NibblesLab/ScanConv/ScanConv.BMP

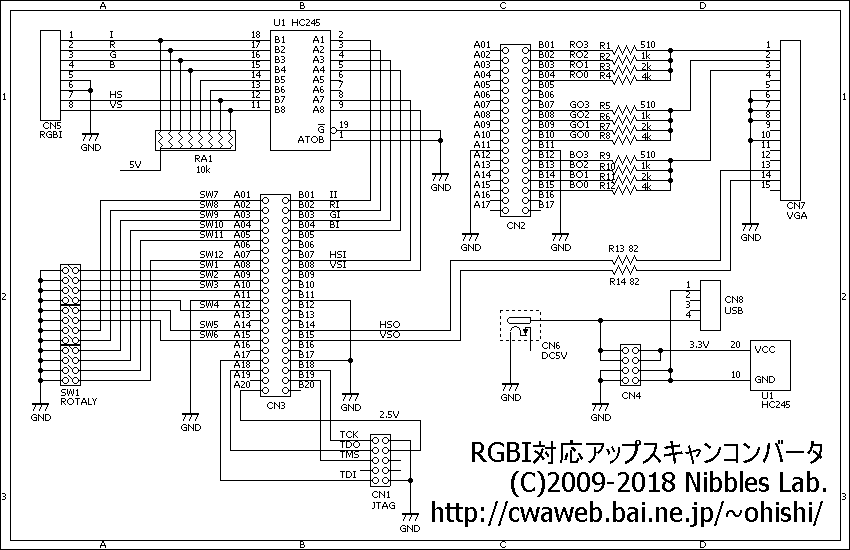
ScanConv.BMP
