NibblesLab/ScanConv/ScanConv.vhd

--
-- Scan Converter for RGBI by Spartan-3E
--
--   (c)2008-2018 Nibbles Lab.
--

-- SW
-- 1  CONV RGB
-- 2       RGBI
-- 3       Gray-8
-- 4       Gray-16
-- 5       Green-8
-- 6       Green-16
-- 7  THRU RGB
-- 8       RGBI
-- 9       Gray-8
-- 10      Gray-16
-- 11      Green-8
-- 12      Green-16

library IEEE;
use IEEE.STD_LOGIC_1164.ALL;
use IEEE.STD_LOGIC_ARITH.ALL;
use IEEE.STD_LOGIC_UNSIGNED.ALL;

---- Uncomment the following library declaration if instantiating
---- any Xilinx primitives in this code.
library UNISIM;
use UNISIM.VComponents.all;

entity ScanConv is
	Port (
		-- Base clock (32MHz)
		CLK : in  STD_LOGIC;
		-- Digital RGBI input
		RI : in  STD_LOGIC;
		GI : in  STD_LOGIC;
		BI : in  STD_LOGIC;
		II : in  STD_LOGIC;
		VSI : in  STD_LOGIC;
		HSI : in  STD_LOGIC;
		-- Analog RGB output
		RO : out  STD_LOGIC_VECTOR (3 downto 0);
		GO : out  STD_LOGIC_VECTOR (3 downto 0);
		BO : out  STD_LOGIC_VECTOR (3 downto 0);
		VSO : out  STD_LOGIC;
		HSO : out  STD_LOGIC;
		LED : out STD_LOGIC;
		-- Function selector
		SW : in  STD_LOGIC_VECTOR (1 to 12);
		-- Test port
		TST0 : out STD_LOGIC;
		TST1 : out STD_LOGIC;
		TST2 : out STD_LOGIC;
		TST3 : out STD_LOGIC;
		TST4 : out STD_LOGIC
	);
end ScanConv;

architecture Behavioral of ScanConv is

signal RD : std_logic_vector(3 downto 0);
signal GD : std_logic_vector(3 downto 0);
signal BD : std_logic_vector(3 downto 0);
signal CTR100M : std_logic_vector(12 downto 0);
signal OCTR : std_logic_vector(11 downto 0);
signal ICTR : std_logic_vector(11 downto 0);
signal Hi : std_logic_vector(5 downto 0);
signal Si : std_logic_vector(5 downto 0);
signal BUFO : std_logic_vector(3 downto 0);
signal BUFI : std_logic_vector(3 downto 0);
signal IGRB : std_logic_vector(3 downto 0);
signal HS : std_logic;
signal HBLANK : std_logic;
signal CLK100 : std_logic;
signal CLK64 : std_logic;
signal SELMONO : std_logic;
signal SNSVS : std_logic_vector(5 downto 0) := (others=>'1');
signal CTR50ms : std_logic_vector(21 downto 0) := (others=>'1');
signal FILCTR : std_logic_vector(12 downto 0);
signal FILTMG : std_logic;
signal MVS : std_logic;
signal LVS : std_logic;
signal DHS : std_logic;
signal CHK1 : std_logic;
signal CHK2 : std_logic;
signal CHK3 : std_logic;
signal VSOS : std_logic;
signal HSOS : std_logic;
signal HUNT : std_logic := '1';
signal EFLAG : std_logic := '0';
signal SCTRA : std_logic_vector(2 downto 0);
signal SCTRB : std_logic_vector(2 downto 0);
signal SCTRO : std_logic_vector(2 downto 0);

	COMPONENT ckgen
	PORT(
		U1_CLKIN_IN : IN std_logic;
		U1_RST_IN : IN std_logic;          
		U1_CLKFX_OUT : OUT std_logic;
		U1_CLKIN_IBUFG_OUT : OUT std_logic;
		U1_CLK2X_OUT : OUT std_logic;
		U1_STATUS_OUT : OUT std_logic_vector(7 downto 0);
		U2_CLKFX_OUT : OUT std_logic;
		U2_CLK0_OUT : OUT std_logic;
		U2_LOCKED_OUT : OUT std_logic;
		U2_STATUS_OUT : OUT std_logic_vector(7 downto 0)
		);
	END COMPONENT;

begin

	--
	-- Output
	--
	VSO<=VSOS;
	VSOS<=MVS when SELMONO='1' and SW(7 to 12)="111111" else VSI;
	HSO<=HSOS;
	HSOS<=HS when SW(7 to 12)="111111" else HSI;
	RO<="0000" when HBLANK='1' and SW(7 to 12)="111111" else RD;
	GO<="0000" when HBLANK='1' and SW(7 to 12)="111111" else GD;
	BO<="0000" when HBLANK='1' and SW(7 to 12)="111111" else BD;

	LED<='0';

	TST0<='0';	-- CN2 A01
	TST1<='0';	-- CN2 A03
	TST2<='0';	-- CN2 A07
	TST3<='0';	-- CN2 A09
	TST4<='0';	-- CN2 A13

	--
	-- Sense & select mode
	--
	process( CLK64 ) begin
		if CLK64'event and CLK64='1' then

			-- Sense VSI
			SNSVS<=SNSVS(4 downto 0)&VSI;

			-- Counter & Mode select
			if SNSVS="111000" then	-- VS arrived
				CTR50ms<=(others=>'0');
				SELMONO<='0';
			elsif CTR50ms="1111111111111111111111" then	-- time out
				SELMONO<='1';
			else
				CTR50ms<=CTR50ms+'1';
			end if;

		end if;
	end process;

	--
	-- Filter Hsync from Csync
	--
	process( CLK64 ) begin
		if CLK64'event and CLK64='1' then

			-- Latch pulse
			if FILCTR=3583 then
				FILTMG<='1';
			elsif FILCTR=416 then
				FILTMG<='0';
			end if;

			-- Count & sync
			if FILCTR=3583 then			-- fix length loop
				FILCTR<=(others=>'0');
			elsif FILCTR=28 then			-- 1st check point
				CHK1<=HSI;
				FILCTR<=FILCTR+'1';
			elsif FILCTR=91 then			-- 2nd check point
				CHK2<=HSI;
				FILCTR<=FILCTR+'1';
			elsif FILCTR=273 then		-- 3rd check point
				CHK3<=HSI;
				FILCTR<=FILCTR+'1';
			elsif FILCTR=336 then		-- 4th check point
				if (CHK1='0' and CHK2='1' and CHK3='1' and HSI='0') or (CHK1='1' and CHK2='0' and CHK3='0' and HSI='1') then
					-- just center (+1)
					FILCTR<="0000101010001";
				elsif (CHK1='0' and CHK2='1' and CHK3='0' and HSI='0') or (CHK1='1' and CHK2='0' and CHK3='1' and HSI='1') then
					-- bit later (skip several counts)
					FILCTR<="0000101100000";
				elsif (CHK1='0' and CHK2='0' and CHK3='1' and HSI='0') or (CHK1='1' and CHK2='1' and CHK3='0' and HSI='1') then
					-- bit faster (not count)
					CHK2<=CHK3;
				else
					-- other case (+2)
					FILCTR<="0000101010010";
				end if;
			else
				FILCTR<=FILCTR+'1';
			end if;

		end if;
	end process;

	--
	-- Latch VSI
	--
	process( FILTMG ) begin

		if FILTMG'event and FILTMG='1' then
			LVS<=HSI;
		end if;

	end process;

	MVS<=HSI when FILTMG='0' else LVS;
	DHS<=HSI when SELMONO='0' else not(MVS xor HSI);

	--
	-- Input counter
	--
	process( CLK64 ) begin
		if CLK64'event and CLK64='1' then

			-- Filtering DHS
			Si<=Si(4 downto 0)&DHS;

			-- Counter start
			if Si="111000" then
				ICTR<=X"EE0";
			else
				ICTR<=ICTR+'1';
			end if;

		end if;
	end process;

	BUFI<=II&GI&RI&BI when SELMONO='0' else II&II&II&II;

	--
	-- Output counter
	--
	process( CLK100 ) begin
		if CLK100'event and CLK100='1' then

			-- Filtering DHS
			Hi<=Hi(4 downto 0)&DHS;

			-- Counter
			if HUNT='1' then		-- search the edge
				if Hi="110000" then
					CTR100M<=(others=>'0');
					OCTR<=(others=>'0');
					HUNT<='0';
				else
					CTR100M<=CTR100M+'1';
				end if;
			else
				if CTR100M(12 downto 4)=399 and CTR100M(3 downto 0)/="1111" then
					if Hi="110000" then
						EFLAG<='1';
						SCTRA<=(others=>'0');
						if SCTRB=7 then
							SCTRB<=(others=>'0');
							CTR100M<=CTR100M+2;
						else
							SCTRB<=SCTRB+'1';
							CTR100M<=CTR100M+'1';
						end if;
					else
						CTR100M<=CTR100M+'1';
					end if;
					OCTR<=OCTR+'1';
				elsif CTR100M=6399 then
					if Hi="110000" then
						EFLAG<='1';
					end if;
					OCTR<=(others=>'0');
					CTR100M<=(others=>'0');
				elsif CTR100M=6400 then
					OCTR<=(0=>'1', others=>'0');
					CTR100M<=(0=>'1', others=>'0');
				elsif CTR100M(12 downto 4)=0 then
					if Hi="110000" then
						EFLAG<='1';
						SCTRB<=(others=>'0');
						if SCTRA=7 then
							SCTRA<=(others=>'0');
						else
							SCTRA<=SCTRA+'1';
							CTR100M<=CTR100M+'1';
						end if;
					else
						CTR100M<=CTR100M+'1';
					end if;
					OCTR<=OCTR+'1';
				elsif CTR100M=16 then
					if EFLAG='0' then		-- if not detect the edge at center and +/- 16 counts
						if SCTRO=7 then	-- to HUNT mode
							HUNT<='1';
							SCTRO<=(others=>'0');
						else
							SCTRO<=SCTRO+'1';
						end if;
					else
						SCTRO<=(others=>'0');
						EFLAG<='0';
					end if;
					OCTR<=OCTR+'1';
					CTR100M<=CTR100M+'1';
				elsif CTR100M=3199 then		-- half of horizontal time
					OCTR<=(others=>'0');
					CTR100M<=CTR100M+'1';
				else
					OCTR<=OCTR+'1';
					CTR100M<=CTR100M+'1';
				end if;
			end if;

			-- Horizontal Sync genarate
			if OCTR=0 then
				HS<='0';
			elsif OCTR=1 then
				HS<='0';
			elsif OCTR=354 then
				HS<='1';
			end if;

			-- Horizontal Blanking Time counter
			if OCTR=40 then
				HBLANK<='1';
			elsif OCTR=466 then
				HBLANK<='0';
			end if;

		end if;
	end process;

	--
	-- Contert from digital RGBI to analog RGB
	--
	IGRB<=BUFO when SW(7 to 12)="111111" else BUFI;
	process( SW, IGRB ) begin
		if SW(1)='0' or SW(7)='0' then	--	RGB
			case IGRB is
--				when "0000"|"1000" =>
--					RD<=(others=>'0');
--					BD<=(others=>'0');
--					GD<=(others=>'0');
				when "0001"|"1001" =>
					RD<=(others=>'0');
					BD<=(others=>'1');
					GD<=(others=>'0');
				when "0010"|"1010" =>
					RD<=(others=>'1');
					BD<=(others=>'0');
					GD<=(others=>'0');
				when "0011"|"1011" =>
					RD<=(others=>'1');
					BD<=(others=>'1');
					GD<=(others=>'0');
				when "0100"|"1100" =>
					RD<=(others=>'0');
					BD<=(others=>'0');
					GD<=(others=>'1');
				when "0101"|"1101" =>
					RD<=(others=>'0');
					BD<=(others=>'1');
					GD<=(others=>'1');
				when "0110"|"1110" =>
					RD<=(others=>'1');
					BD<=(others=>'0');
					GD<=(others=>'1');
				when "0111"|"1111" =>
					RD<=(others=>'1');
					BD<=(others=>'1');
					GD<=(others=>'1');
				when others =>
					RD<=(others=>'0');
					BD<=(others=>'0');
					GD<=(others=>'0');
			end case;
		elsif SW(2)='0' or SW(8)='0' then	--	RGBI
			case IGRB is
--				when "0000" =>
--					RD<=(others=>'0');
--					BD<=(others=>'0');
--					GD<=(others=>'0');
				when "0001" =>
					RD<=(others=>'0');
					BD<="1000";
					GD<=(others=>'0');
				when "0010" =>
					RD<="1000";
					BD<=(others=>'0');
					GD<=(others=>'0');
				when "0011" =>
					RD<="1000";
					BD<="1000";
					GD<=(others=>'0');
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
      INIT_39 => X"0000000000000000000000000000000000000000000000000000000000000000",
      INIT_3A => X"0000000000000000000000000000000000000000000000000000000000000000",
      INIT_3B => X"0000000000000000000000000000000000000000000000000000000000000000",
      INIT_3C => X"0000000000000000000000000000000000000000000000000000000000000000",
      INIT_3D => X"0000000000000000000000000000000000000000000000000000000000000000",
      INIT_3E => X"0000000000000000000000000000000000000000000000000000000000000000",
      INIT_3F => X"0000000000000000000000000000000000000000000000000000000000000000")
   port map (
      DOA => open,     -- Port A 4-bit Data Output
      DOB => BUFO,     -- Port B 4-bit Data Output
      ADDRA => ICTR,   -- Port A 12-bit Address Input
      ADDRB => OCTR,   -- Port B 12-bit Address Input
      CLKA => CLK64,   -- Port A Clock
      CLKB => CLK100,  -- Port B Clock
      DIA => BUFI,     -- Port A 4-bit Data Input
      DIB => "0000",   -- Port B 4-bit Data Input
      ENA => '1',      -- Port A RAM Enable Input
      ENB => '1',      -- Port B RAM Enable Input
      SSRA => '0',     -- Port A Synchronous Set/Reset Input
      SSRB => '0',     -- Port B Synchronous Set/Reset Input
      WEA => '1',      -- Port A Write Enable Input
      WEB => '0'       -- Port B Write Enable Input
   );

	Inst_ckgen: ckgen PORT MAP(
		U1_CLKIN_IN => CLK,
		U1_RST_IN => '0',
		U1_CLKFX_OUT => CLK64,
		U1_CLKIN_IBUFG_OUT => open,
		U1_CLK2X_OUT => open,
		U1_STATUS_OUT => open,
		U2_CLKFX_OUT => CLK100,
		U2_CLK0_OUT => open,
		U2_LOCKED_OUT => open,
		U2_STATUS_OUT => open
	);

end Behavioral;
