NibblesLab/ScanConv/(commit log)

2018-10-15 First commit
    「First」と言いつつ、実際には強制ブランキング発生まで実装したバージョン
2018-10-15 配布用Zipに同梱していたReadMe.txtの内容を暫定的に記述
2018-10-17 Markdown形式による整形
2018-10-18 以前のZipの内容に揃えるためのコミット
2018-10-19 配布ファイルとしては不要のため
2018-11-12 MZ-2200モノクロ出力対応
2018-11-12 MZ-2200 モノクロ出力対応に準じた内容に変更
2018-11-13 回路の変更を反映
